sierrafoxtrot/PDP-8_Serial_AIO/discrete/simulation/tx/Simluation_151026_1.png

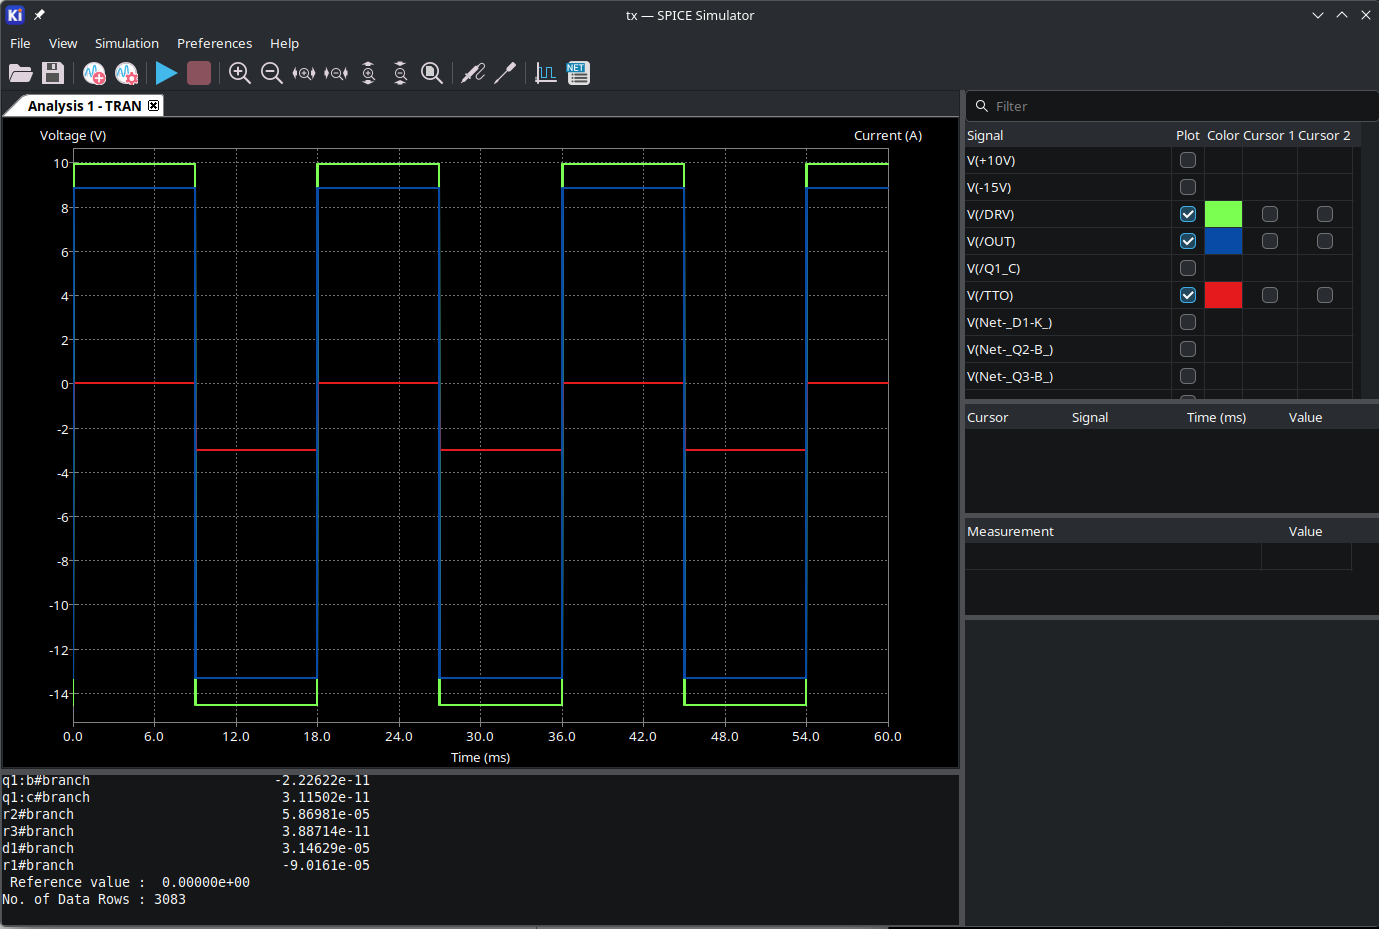
discrete/simulation/tx/Simluation_151026_1.png
