sierrafoxtrot/PDP-8_Serial_AIO/ic/PDP-8-Serial-IC.kicad_pcb

## KiCad design ic/PDP-8-Serial-IC.kicad_pcb (2026-11-01)

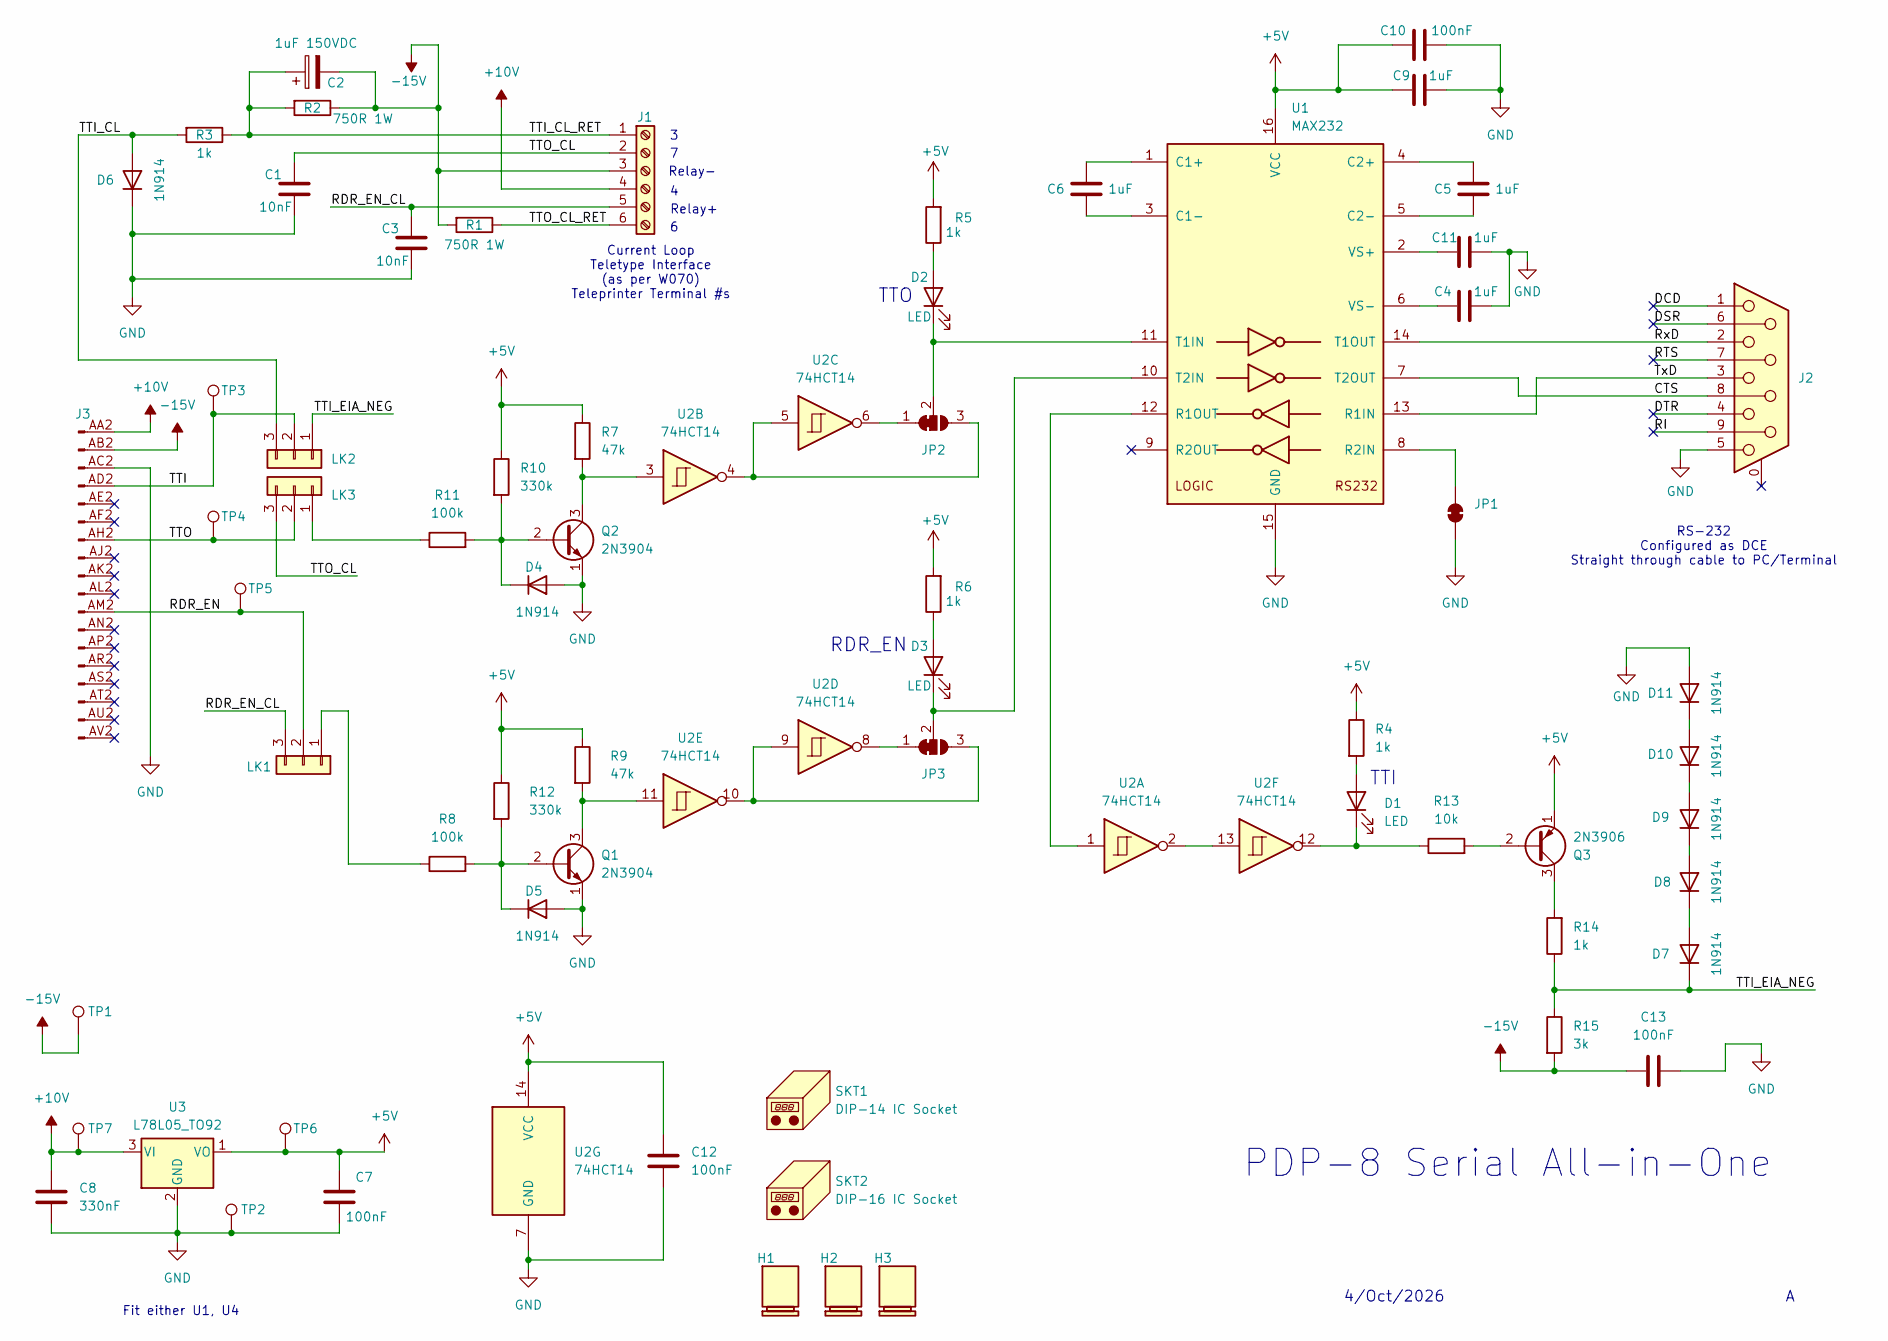
[picture p2: schematic PDP-8-Serial-IC.kicad_sch]

Parts:
C1, C3: 10nF; C_Disc_D5.0mm_W2.5mm_P2.50mm; MPN RDER71H103K0K1H03B; Digikey_PN 490-8812-ND
C2: 1uF 150VDC; CP_Axial_L29.0mm_D13.0mm_P35.00mm_Horizontal; MPN MKP1839510254; Digikey_PN 2870-MKP1839510254-ND
C4, C5, C6, C9, C11: 1uF; C_Disc_D5.0mm_W2.5mm_P5.00mm; MPN RDER71H105K2K1H03B; Digikey_PN 490-8816-ND
C7, C10, C12, C13: 100nF; C_Disc_D5.0mm_W2.5mm_P2.50mm; MPN RDER71H104K0S1H03A; Digikey_PN 490-9145-1-ND
C8: 330nF; C_Disc_D5.0mm_W2.5mm_P5.00mm; MPN FA14X7R1H334KNU06; Digikey_PN 445-180408-1-ND
D1, D2, D3: LED; LED_D3.0mm; MPN LTL1CHKEKNN; Digikey_PN 160-1943-ND
D4, D5, D6, D7, D8, D9, D10, D11: 1N914; D_DO-35_SOD27_P7.62mm_Horizontal; MPN 1N914B; Digikey_PN 1N914B-ND
H1, H2, H3: Jumper_Shunt; MPN QPC02SXGN-RC; DigiKey_PN S9337-ND
J1: Screw_Terminal_01x06; PhoenixContact_MC_1,5_6-G-3.5_1x06_P3.50mm_Horizontal
J2: DE9_Socket_MountingHoles; DSUB-9_Pins_Horizontal_P2.77x2.84mm_EdgePinOffset7.70mm_Hou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; MPN A-DF 09 A/KG-T2S; Digikey_PN AE10921-ND
J3: FlipChip_01x18; DEC_single_short_holeless
JP1: SolderJumper_2_Bridged; SolderJumper-2_P1.3mm_Bridged2Bar_RoundedPad1.0x1.5mm
JP2, JP3: SolderJumper_3_Bridged12; SolderJumper-3_P1.3mm_Bridged2Bar12_RoundedPad1.0x1.5mm_Num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
LK1, LK2, LK3: Conn_01x03; PinHeader_1x03_P2.54mm_Vertical; MPN PREC003SAAAN-RC; Digikey_PN S1012EC-03-ND
Q1, Q2: 2N3904; TO-92_Inline; MPN 2N3904BU; Digikey_PN 2N3904FS-ND
Q3: 2N3906; TO-92_Inline; MPN 2N3906BU; Digikey_PN 2N3906FS-ND
R1, R2: 750R 1W; R_Axial_DIN0414_L11.9mm_D4.5mm_P20.32mm_Horizontal; MPN RSF100JB-73-750R; Digikey_PN 13-RSF100JB-73-750R-ND
R3, R4, R5, R6, R14: 1k; R_Axial_DIN0207_L6.3mm_D2.5mm_P10.16mm_Horizontal; MPN MFR-25FBF52-1K; Digikey_PN 1.00KXBK-ND
R7, R9: 47k; R_Axial_DIN0207_L6.3mm_D2.5mm_P10.16mm_Horizontal; MPN RES 47K OHM 1% 1/4W AXIAL; Digikey_PN MFR-25FBF52-47K-ND
R8, R11: 100k; R_Axial_DIN0207_L6.3mm_D2.5mm_P10.16mm_Horizontal; MPN MFR-25FBF52-100K; Digikey_PN 100KXBK-ND
R10, R12: 330k; R_Axial_DIN0207_L6.3mm_D2.5mm_P10.16mm_Horizontal; MPN MFR-25FBF52-330K; Digikey_PN MFR-25FBF52-330K-ND
R13: 10k; R_Axial_DIN0207_L6.3mm_D2.5mm_P10.16mm_Horizontal; MPN MFR-25FBF52-10K; Digikey_PN 10.0KXBK-ND
R15: 3k; R_Axial_DIN0207_L6.3mm_D2.5mm_P10.16mm_Horizontal; MPN MFR-25FBF52-3K; Digikey_PN 13-MFR-25FBF52-3K-ND
SKT1: DIP-14 IC Socket; MPN A 14-LC-TT; Digikey_PN AE9989-ND
SKT2: DIP-16 IC Socket; MPN A 16-LC-TT; Digikey_PN AE9992-ND
TP1: -15V; TestPoint_Loop_D3.50mm_Drill0.9mm_Beaded
TP2: GND; TestPoint_Loop_D3.50mm_Drill0.9mm_Beaded
TP3: TTI; TestPoint_Loop_D3.50mm_Drill0.9mm_Beaded
TP4: TTO; TestPoint_Loop_D3.50mm_Drill0.9mm_Beaded
TP5: RDR_EN; TestPoint_Loop_D3.50mm_Drill0.9mm_Beaded
TP6: +5V; TestPoint_Loop_D3.50mm_Drill0.9mm_Beaded
TP7: +10V; TestPoint_Loop_D3.50mm_Drill0.9mm_Beaded
U1: MAX232; DIP-16_W7.62mm; MPN MAX232EIN; Digikey_PN 296-27963-5-ND
U2: 74HCT14; DIP-14_W7.62mm; MPN SN74HCT14N; Digikey_PN 296-8394-5-ND
U3: L78L05_TO92; TO-92_Inline; MPN L78L05ACZ; Digikey_PN 497-2952-ND

Connections:
+5V: C7.1, C9.1, C10.1, C12.1, Q3.1 (E), R4.1, R5.2, R6.2, R7.1, R9.1, R10.1, R12.1, TP6.1, U1.16 (VCC), U2.14 (VCC), U3.1 (VO)
+10V: C8.1, J1.4, J3.AA2 (Pin_A), TP7.1, U3.3 (VI)
-15V: C2.2, C13.1, J1.3, J3.AB2 (Pin_B), R1.2, R2.1, R15.2, TP1.1
/CTS: J2.8, U1.7 (T2OUT)
/DCD: J2.1
/DSR: J2.6
/DTR: J2.4
/RDR_EN: J3.AM2 (Pin_M), LK1.2, TP5.1
/RDR_EN_CL: C3.1, J1.5, LK1.3
/RI: J2.9
/RTS: J2.7
/RxD: J2.2, U1.14 (T1OUT)
/TTI: J3.AD2 (Pin_D), LK2.2, TP3.1
/TTI_CL: D6.2 (A), LK2.3, R3.2
/TTI_CL_RET: C2.1, J1.1, R2.2, R3.1
/TTI_EIA_NEG: D7.1 (K), LK2.1, R14.1, R15.1
/TTO: J3.AH2 (Pin_H), LK3.2, TP4.1
/TTO_CL: C1.1, J1.2, LK3.3
/TTO_CL_RET: J1.6, R1.1
/TxD: J2.3, U1.13 (R1IN)
GND: C1.2, C3.2, C4.2, C7.2, C8.2, C9.2, C10.2, C11.2, C12.2, C13.2, D4.2 (A), D5.2 (A), D6.1 (K), D11.2 (A), J2.5, J3.AC2 (Pin_C), JP1.2 (B), Q1.1 (E), Q2.1 (E), TP2.1, U1.15 (GND), U2.7 (GND), U3.2 (GND)
unnamed: D1.2 (A), R4.2
unnamed: D1.1 (K), R13.1, U2.12
unnamed: D2.2 (A), R5.1
unnamed: D2.1 (K), JP2.2 (C), U1.11 (T1IN)
unnamed: D3.2 (A), R6.1
unnamed: D3.1 (K), JP3.2 (C), U1.10 (T2IN)
unnamed: D4.1 (K), Q2.2 (B), R10.2, R11.2
unnamed: D5.1 (K), Q1.2 (B), R8.2, R12.2
unnamed: D7.2 (A), D8.1 (K)
unnamed: D8.2 (A), D9.1 (K)
unnamed: D10.2 (A), D11.1 (K)
unnamed: D9.2 (A), D10.1 (K)
unnamed: JP1.1 (A), U1.8 (R2IN)
unnamed: JP2.1 (A), U2.6
unnamed: JP2.3 (B), U2.4, U2.5
unnamed: JP3.1 (A), U2.8
unnamed: JP3.3 (B), U2.9, U2.10
unnamed: LK1.1, R8.1
unnamed: LK3.1, R11.1
unnamed: Q1.3 (C), R9.2, U2.11
unnamed: Q2.3 (C), R7.2, U2.3
unnamed: Q3.2 (B), R13.2
unnamed: Q3.3 (C), R14.2
unnamed: C6.2, U1.1 (C1+)
unnamed: C6.1, U1.3 (C1-)
unnamed: C5.2, U1.4 (C2+)
unnamed: C5.1, U1.5 (C2-)
unnamed: U1.12 (R1OUT), U2.1
unnamed: C11.1, U1.2 (VS+)
unnamed: C4.1, U1.6 (VS-)
unnamed: U2.2, U2.13

Notes on the sheet:
Relay-
TTI
Relay+
Fit either U1, U4
PDP-8 Serial All-in-One
RS-232 Configured as DCE Straight through cable to PC/Terminal
4/Oct/2026
Current Loop Teletype Interface (as per W070) Teleprinter Terminal #s
RDR_EN
TTO

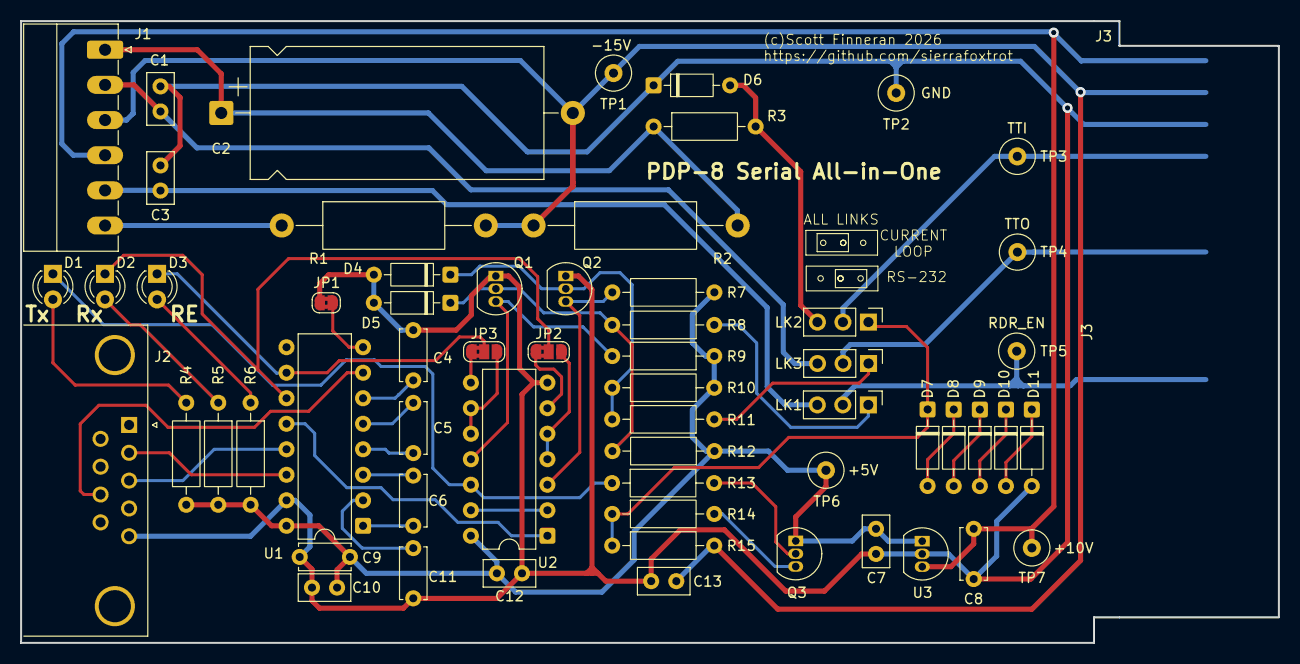
[picture p3: board PDP-8-Serial-IC.kicad_pcb from above]

Board: 2 copper layers, 125.2 x 61.9 mm, 61 parts (0 on the bottom side), 47 nets.
