sierrafoxtrot/PDP-8_Serial_AIO/discrete/hardware/PDP-8-Serial-Discrete.kicad_pcb

## KiCad design discrete/hardware/PDP-8-Serial-Discrete.kicad_pcb (2026-11-01)

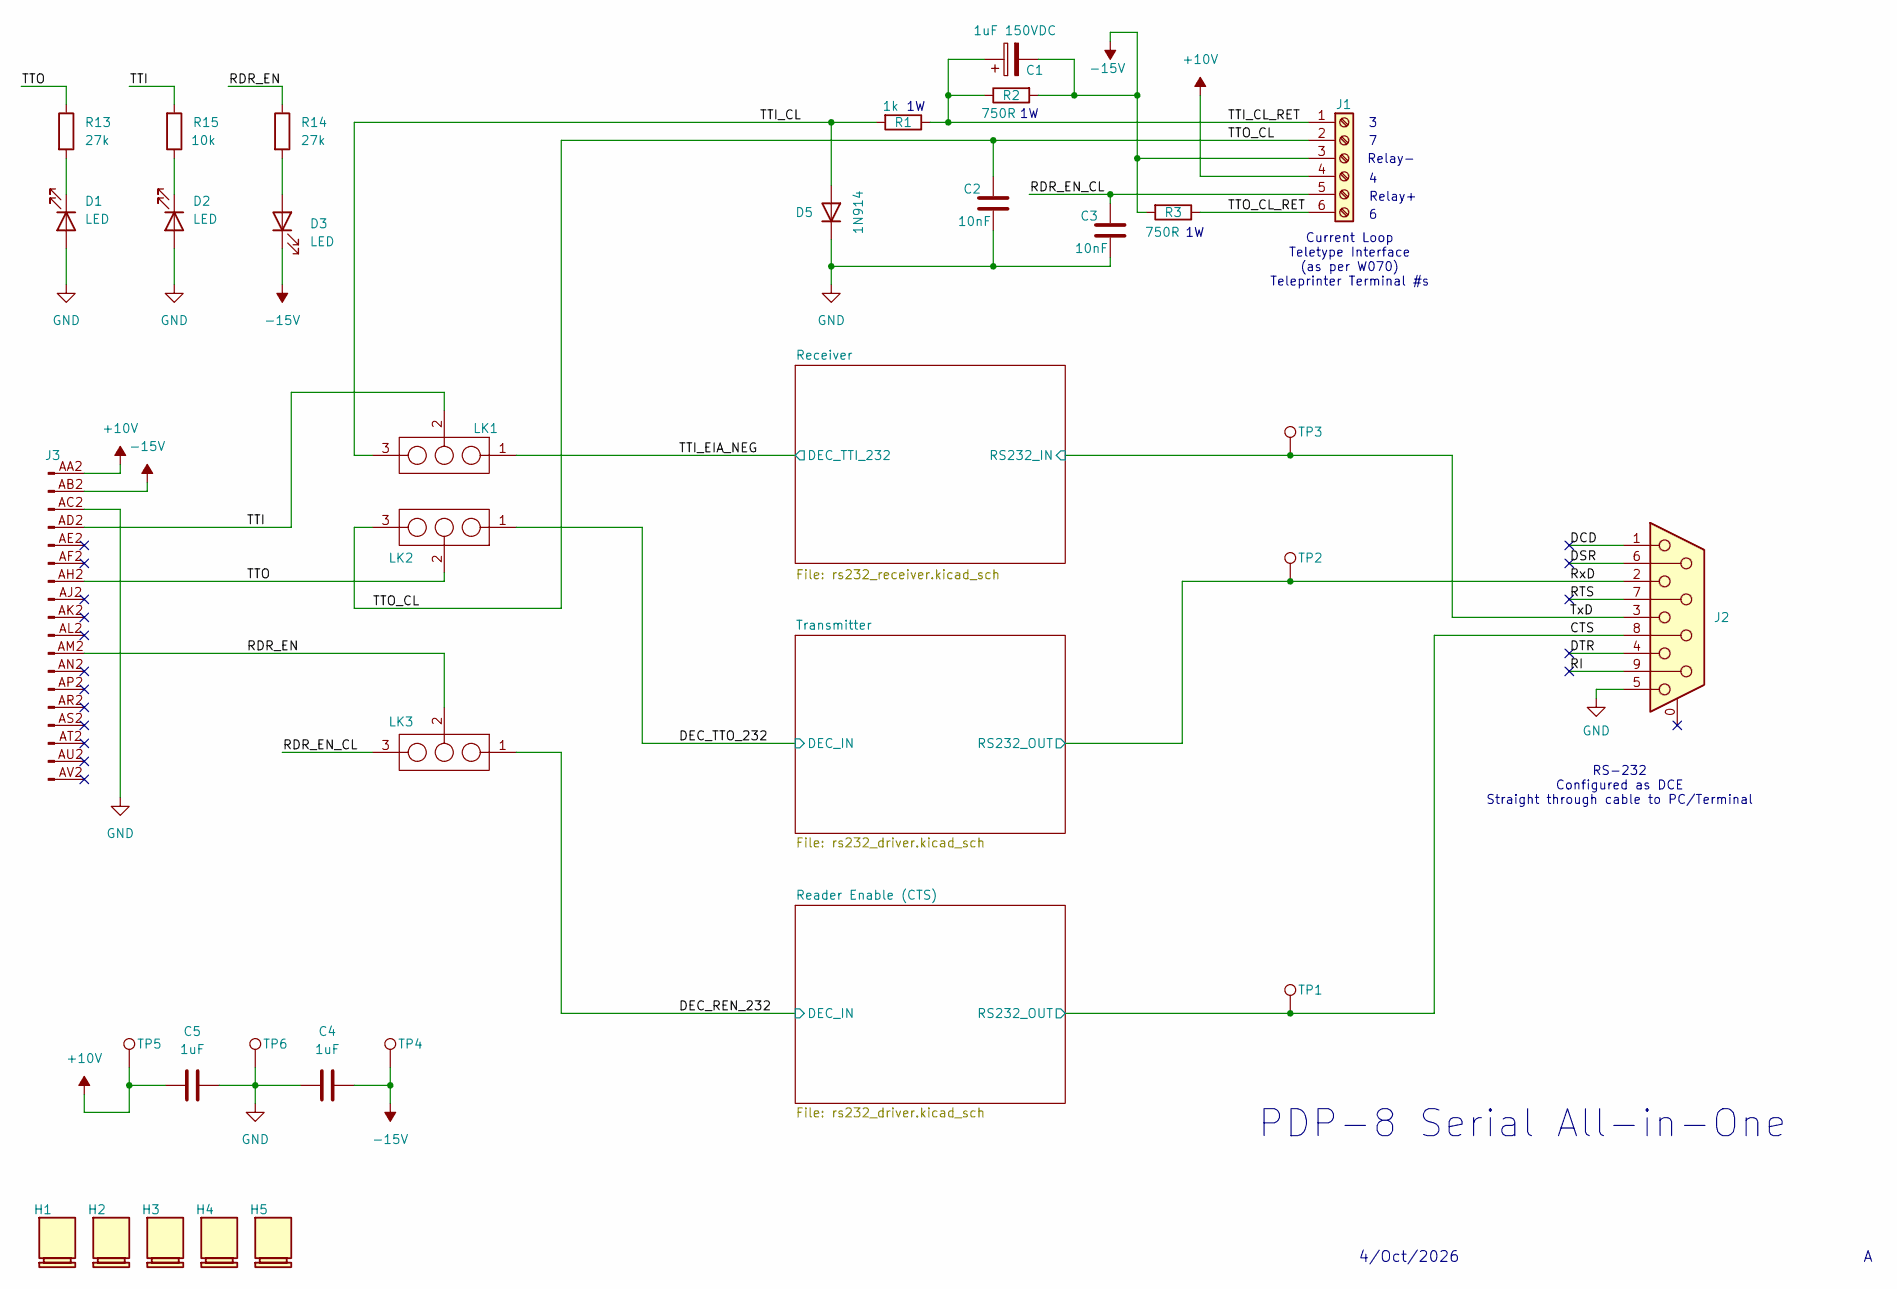
[picture p4: schematic PDP-8-Serial-Discrete.kicad_sch]

Parts:
C1: 1uF 150VDC; CP_Axial_L29.0mm_D13.0mm_P35.00mm_Horizontal; MPN MKP1839510254; DigiKey_PN 2870-MKP1839510254-ND
C2, C3: 10nF; C_Disc_D5.0mm_W2.5mm_P2.50mm; MPN RDER71H103K0K1H03B; DigiKey_PN 490-8812-ND
C4, C5: 1uF; C_Disc_D5.0mm_W2.5mm_P5.00mm; MPN RDER71H105K2K1H03B; DigiKey_PN 490-8816-ND
D1, D2, D3: LED; LED_D3.0mm; MPN LTL1CHKEKNN; DigiKey_PN 160-1943-ND
D5: 1N914; D_DO-35_SOD27_P7.62mm_Horizontal; MPN 1N914B; DigiKey_PN 1N914B-ND
H1, H2, H3, H4, H5: Jumper_Shunt; MPN QPC02SXGN-RC; DigiKey_PN S9337-ND
J1: Screw_Terminal_01x06; PhoenixContact_MC_1,5_6-G-3.5_1x06_P3.50mm_Horizontal
J2: DE9_Socket_MountingHoles; DSUB-9_Pins_Horizontal_P2.77x2.84mm_EdgePinOffset7.70mm_Hou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; MPN A-DF 09 A/KG-T2S; DigiKey_PN AE10921-ND
J3: FlipChip_01x18; DEC_single_short_holeless
LK1, LK2, LK3: Link_01x03; PinHeader_1x03_P2.54mm_Vertical; MPN PREC003SAAAN-RC; DigiKey_PN S1012EC-03-ND
R1: 1k; R_Axial_DIN0414_L11.9mm_D4.5mm_P20.32mm_Horizontal; MPN MFR-25FBF52-1K; DigiKey_PN 1.00KXBK-ND
R2, R3: 750R; R_Axial_DIN0414_L11.9mm_D4.5mm_P20.32mm_Horizontal; MPN RSF100JB-73-750R; DigiKey_PN 13-RSF100JB-73-750R-ND
R13, R14: 27k; R_Axial_DIN0207_L6.3mm_D2.5mm_P7.62mm_Horizontal; MPN RES 27K OHM 1% 1/4W AXIAL; DigiKey_PN MFR-25FBF52-27K-ND
R15: 10k; R_Axial_DIN0207_L6.3mm_D2.5mm_P7.62mm_Horizontal; MPN MFR-25FBF52-10K; DigiKey_PN 10.0KXBK-ND
TP1: CTS; TestPoint_Loop_D3.50mm_Drill0.9mm_Beaded
TP2: RxD; TestPoint_Loop_D3.50mm_Drill0.9mm_Beaded
TP3: TxD; TestPoint_Loop_D3.50mm_Drill0.9mm_Beaded
TP4: -15V; TestPoint_Loop_D3.50mm_Drill0.9mm_Beaded
TP5: +10V; TestPoint_Loop_D3.50mm_Drill0.9mm_Beaded
TP6: GND; TestPoint_Loop_D3.50mm_Drill0.9mm_Beaded

Connections:
+10V: C5.1, J1.4, J3.AA2 (Pin_A), TP5.1; also elsewhere on the board
-15V: C1.2, C4.1, D3.1 (K), J1.3, J3.AB2 (Pin_B), R2.2, R3.2, TP4.1; also elsewhere on the board
/CTS: J2.8, TP1.1; also elsewhere on the board
/DCD: J2.1
/DEC_REN_232: LK3.1; also elsewhere on the board
/DEC_TTO_232: LK2.1; also elsewhere on the board
/DSR: J2.6
/DTR: J2.4
/RDR_EN: J3.AM2 (Pin_M), LK3.2, R14.1
/RDR_EN_CL: C3.1, J1.5, LK3.3
/RI: J2.9
/RTS: J2.7
/RxD: J2.2, TP2.1; also elsewhere on the board
/TTI: J3.AD2 (Pin_D), LK1.2, R15.2
/TTI_CL: D5.2 (A), LK1.3, R1.2
/TTI_CL_RET: C1.1, J1.1, R1.1, R2.1
/TTI_EIA_NEG: LK1.1; also elsewhere on the board
/TTO: J3.AH2 (Pin_H), LK2.2, R13.1
/TTO_CL: C2.1, J1.2, LK2.3
/TTO_CL_RET: J1.6, R3.1
/TxD: J2.3, TP3.1; also elsewhere on the board
GND: C2.2, C3.2, C4.2, C5.2, D1.2 (A), D2.2 (A), D5.1 (K), J2.5, J3.AC2 (Pin_C), TP6.1; also elsewhere on the board
unnamed: D1.1 (K), R13.2
unnamed: D2.1 (K), R15.1
unnamed: D3.2 (A), R14.2

Notes on the sheet:
Relay-
Relay+
PDP-8 Serial All-in-One
RS-232 Configured as DCE Straight through cable to PC/Terminal
4/Oct/2026
Current Loop Teletype Interface (as per W070) Teleprinter Terminal #s

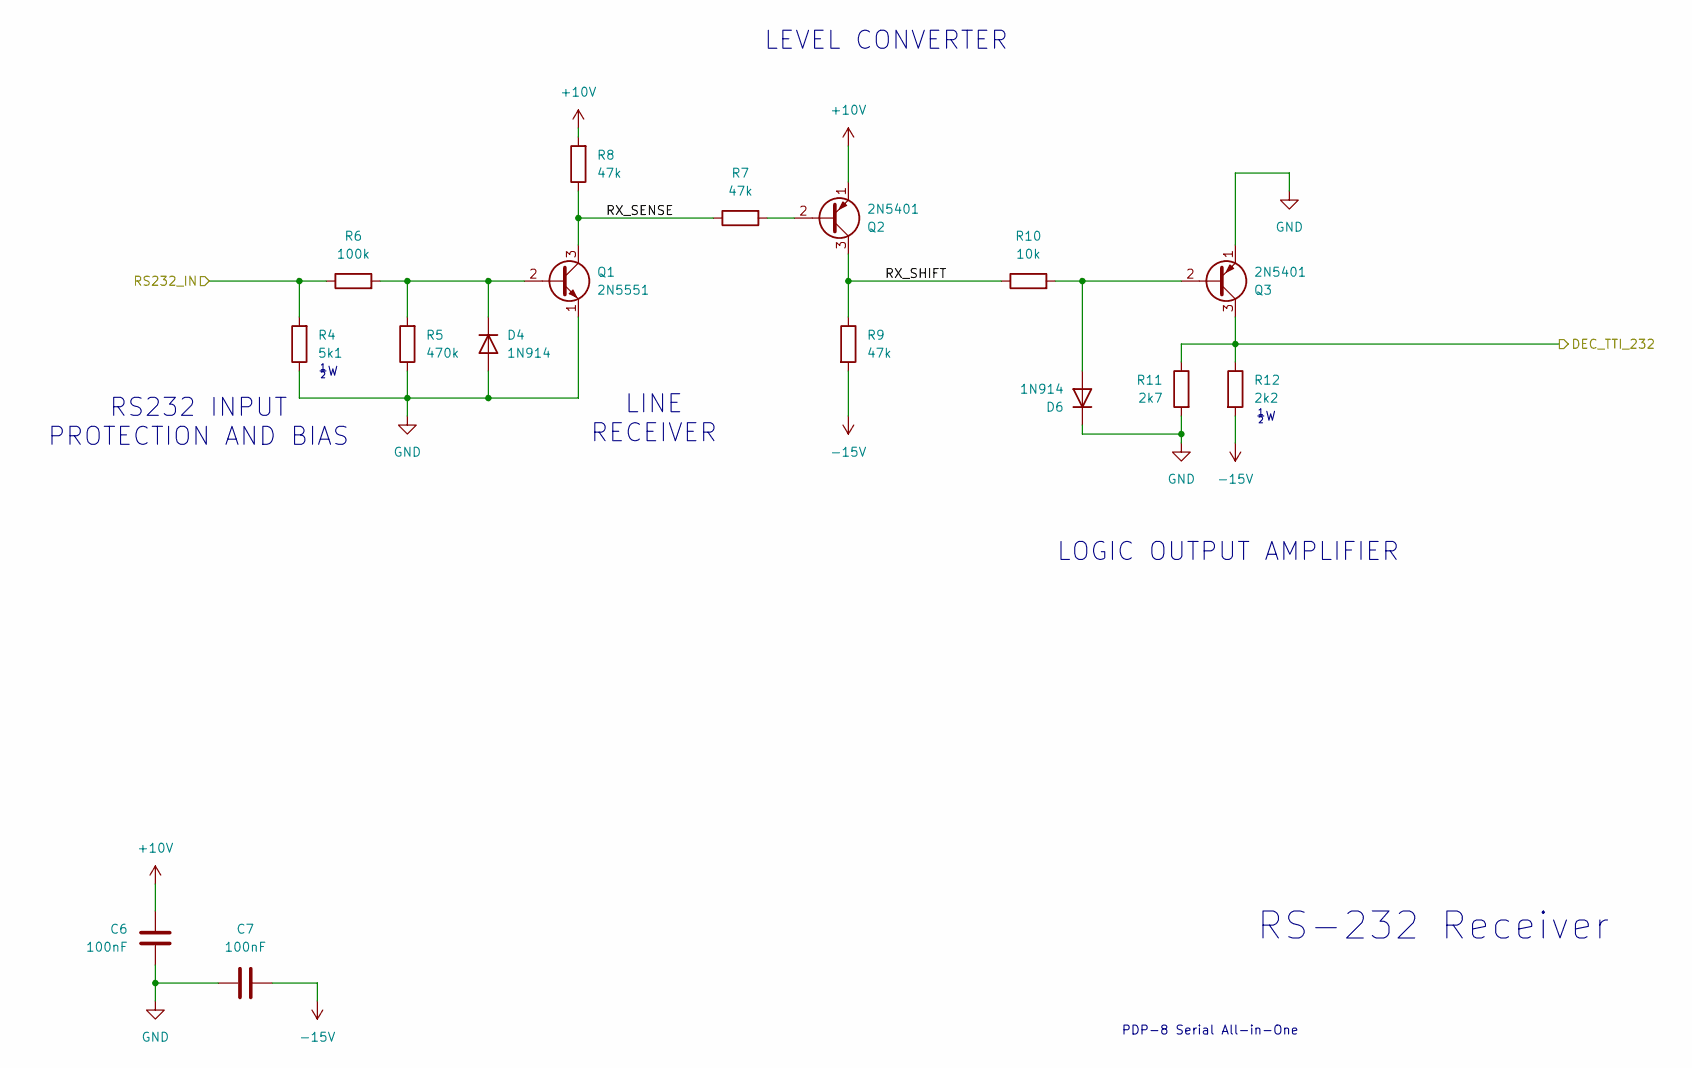
[picture p5: schematic rs232_receiver.kicad_sch]

Parts:
C6, C7: 100nF; C_Disc_D5.0mm_W2.5mm_P2.50mm; MPN RDER71H104K0S1H03A; DigiKey_PN 490-9145-1-ND
D4, D6: 1N914; D_DO-35_SOD27_P7.62mm_Horizontal; MPN 1N914B; DigiKey_PN 1N914B-ND
Q1: 2N5551; TO-92_Inline; MPN 2N5551; DigiKey_PN 4878-2N5551CT-ND
Q2, Q3: 2N5401; TO-92_Inline; MPN 2N5401; DigiKey_PN 4878-2N5401CT-ND
R4: 5k1; R_Axial_DIN0309_L9.0mm_D3.2mm_P12.70mm_Horizontal; MPN MFR-50FRF52-5K1; DigiKey_PN 13-MFR50SFTE52-5K1CT-ND
R5: 470k; R_Axial_DIN0207_L6.3mm_D2.5mm_P7.62mm_Horizontal; MPN MFR-25FBF52-470K; DigiKey_PN MFR-25FBF52-470K-ND
R6: 100k; R_Axial_DIN0207_L6.3mm_D2.5mm_P7.62mm_Horizontal; MPN MFR-25FBF52-100K; DigiKey_PN 100KXBK-ND
R7, R8, R9: 47k; R_Axial_DIN0207_L6.3mm_D2.5mm_P7.62mm_Horizontal; MPN RES 47K OHM 1% 1/4W AXIAL; DigiKey_PN MFR-25FBF52-47K-ND
R10: 10k; R_Axial_DIN0207_L6.3mm_D2.5mm_P7.62mm_Horizontal; MPN MFR-25FBF52-10K; DigiKey_PN 10.0KXBK-ND
R11: 2k7; R_Axial_DIN0207_L6.3mm_D2.5mm_P7.62mm_Horizontal; MPN RES 2.7K OHM 1% 1/4W AXIAL; DigiKey_PN MFR-25FBF52-2K7-ND
R12: 2k2; R_Axial_DIN0309_L9.0mm_D3.2mm_P12.70mm_Horizontal; MPN MFR50SFTE52-2K2; DigiKey_PN 13-MFR50SFTE52-2K2CT-ND

Connections:
+10V: C6.1, Q2.1 (E), R8.2; also elsewhere on the board
-15V: C7.2, R9.2, R12.2; also elsewhere on the board
/Receiver/RX_SENSE: Q1.3 (C), R7.1, R8.1
/Receiver/RX_SHIFT: Q2.3 (C), R9.1, R10.1
/TTI_EIA_NEG: Q3.3 (C), R11.1, R12.1; also elsewhere on the board
/TxD: R4.2, R6.1; also elsewhere on the board
GND: C6.2, C7.1, D4.2 (A), D6.1 (K), Q1.1 (E), Q3.1 (E), R4.1, R5.1, R11.2; also elsewhere on the board
unnamed: D4.1 (K), Q1.2 (B), R5.2, R6.2
unnamed: D6.2 (A), Q3.2 (B), R10.2
unnamed: Q2.2 (B), R7.2

Notes on the sheet:
LEVEL CONVERTER
RS-232 Receiver
PDP-8 Serial All-in-One
RS232 INPUT PROTECTION AND BIAS
LOGIC OUTPUT AMPLIFIER
LINE RECEIVER

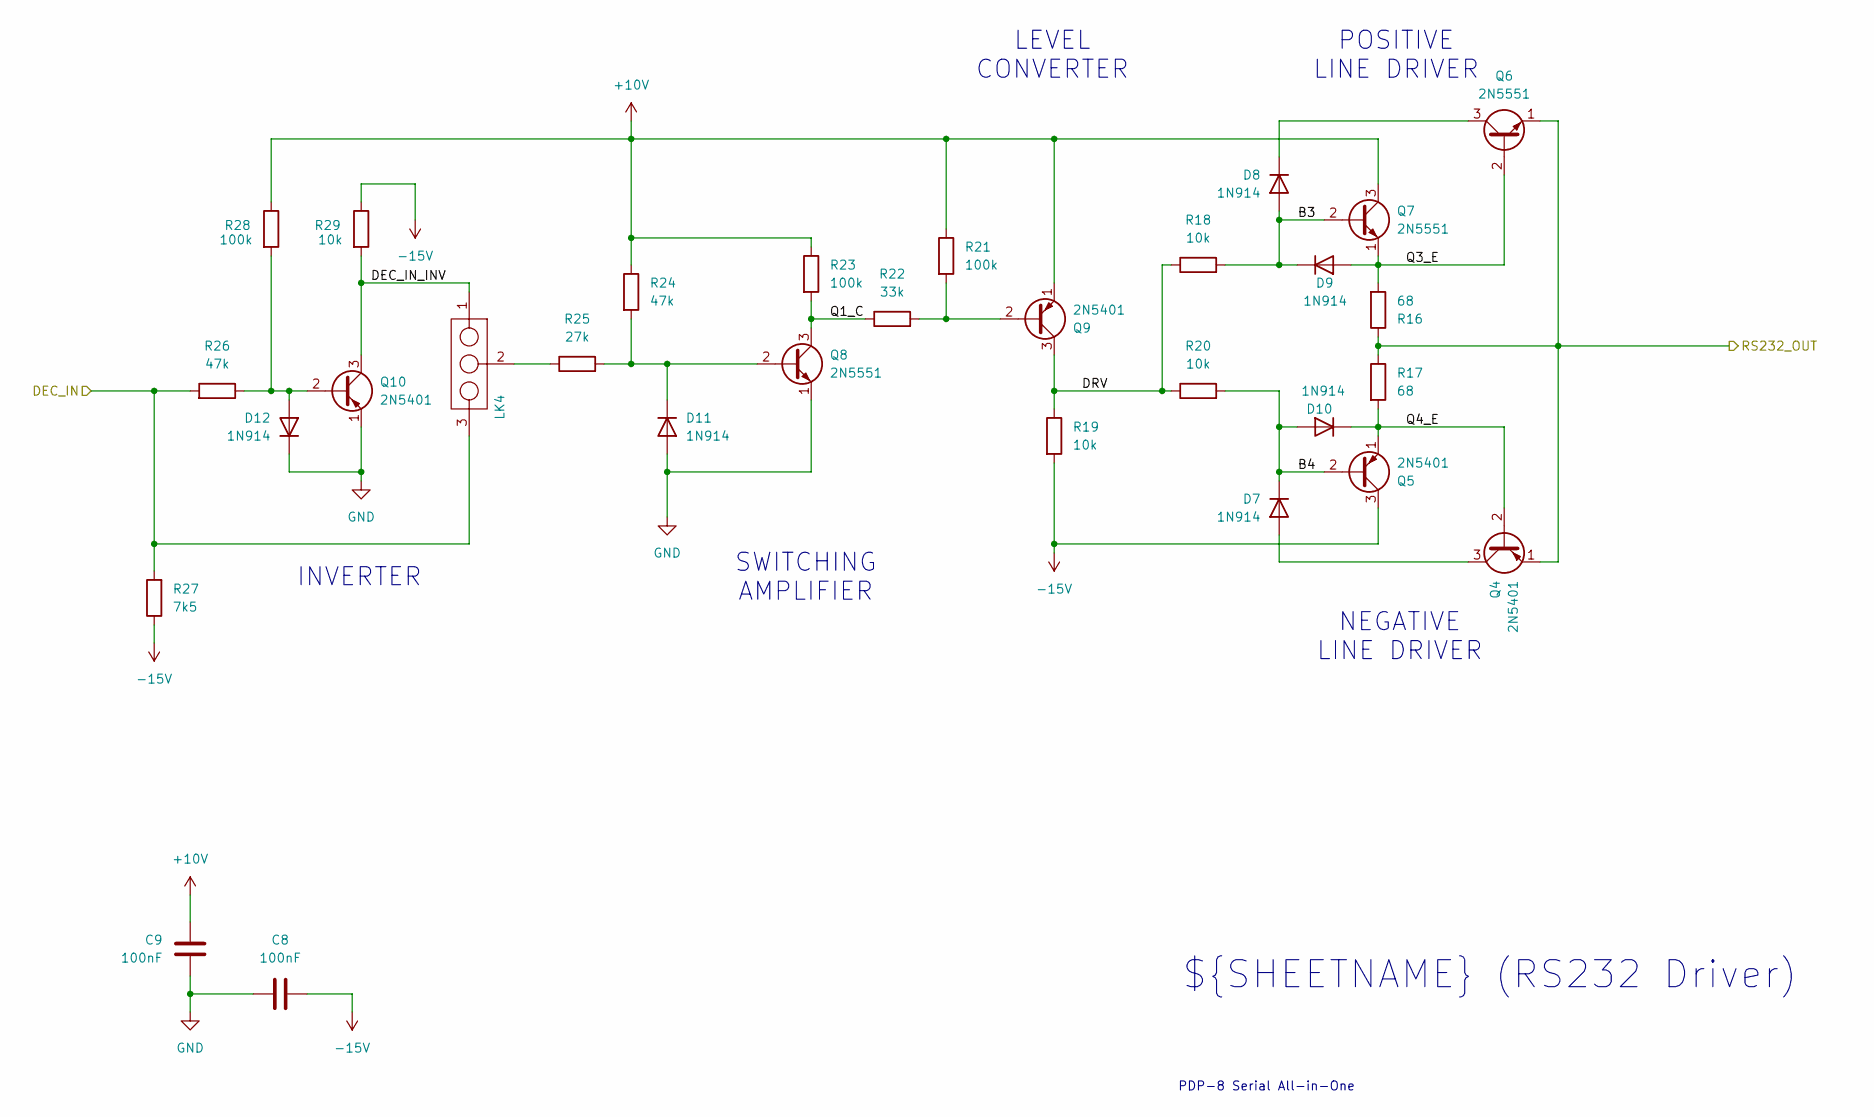
[picture p6: schematic rs232_driver.kicad_sch]

Parts:
C8, C9: 100nF; C_Disc_D5.0mm_W2.5mm_P2.50mm; MPN RDER71H104K0S1H03A; DigiKey_PN 490-9145-1-ND
D7, D8, D9, D10, D11, D12: 1N914; D_DO-35_SOD27_P7.62mm_Horizontal; MPN 1N914B; DigiKey_PN 1N914B-ND
LK4: Link_01x03; PinHeader_1x03_P2.54mm_Vertical; MPN PREC003SAAAN-RC; DigiKey_PN S1012EC-03-ND
Q4, Q5, Q9, Q10: 2N5401; TO-92_Inline; MPN 2N5401; DigiKey_PN 4878-2N5401CT-ND
Q6, Q7, Q8: 2N5551; TO-92_Inline; MPN 2N5551; DigiKey_PN 4878-2N5551CT-ND
R16, R17: 68; R_Axial_DIN0207_L6.3mm_D2.5mm_P7.62mm_Horizontal; MPN RES 68 OHM 1% 1/4W AXIAL; DigiKey_PN 13-MFR-25FBF52-68R-ND
R18, R19, R20, R29: 10k; R_Axial_DIN0207_L6.3mm_D2.5mm_P7.62mm_Horizontal; MPN MFR-25FBF52-10K; DigiKey_PN 10.0KXBK-ND
R21, R23, R28: 100k; R_Axial_DIN0207_L6.3mm_D2.5mm_P7.62mm_Horizontal; MPN MFR-25FBF52-100K; DigiKey_PN 100KXBK-ND
R22: 33k; R_Axial_DIN0207_L6.3mm_D2.5mm_P7.62mm_Horizontal; MPN MFR-25FBF52-33K; DigiKey_PN RES 68 OHM 1% 1/4W AXIAL
R24, R26: 47k; R_Axial_DIN0207_L6.3mm_D2.5mm_P7.62mm_Horizontal; MPN RES 47K OHM 1% 1/4W AXIAL; DigiKey_PN MFR-25FBF52-47K-ND
R25: 27k; R_Axial_DIN0207_L6.3mm_D2.5mm_P7.62mm_Horizontal; MPN RES 27K OHM 1% 1/4W AXIAL; DigiKey_PN MFR-25FBF52-27K-ND
R27: 7k5; R_Axial_DIN0207_L6.3mm_D2.5mm_P7.62mm_Horizontal; MPN RES 7.5K OHM 1% 1/4W AXIAL; DigiKey_PN 7.50KXBK-ND

Connections:
+10V: C9.1, Q7.3 (C), Q9.1 (E), R21.1, R23.1, R24.1, R28.1; also elsewhere on the board
-15V: C8.2, Q5.3 (C), R19.2, R27.1, R29.1; also elsewhere on the board
/DEC_TTO_232: LK4.3, R26.2, R27.2; also elsewhere on the board
/RxD: Q4.1 (E), Q6.1 (E), R16.1, R17.1; also elsewhere on the board
/Transmitter/B3: D8.2 (A), D9.1 (K), Q7.2 (B), R18.2
/Transmitter/B4: D7.1 (K), D10.2 (A), Q5.2 (B), R20.2
/Transmitter/DEC_IN_INV: LK4.1, Q10.3 (C), R29.2
/Transmitter/DRV: Q9.3 (C), R18.1, R19.1, R20.1
/Transmitter/Q1_C: Q8.3 (C), R22.1, R23.2
/Transmitter/Q3_E: D9.2 (A), Q6.2 (B), Q7.1 (E), R16.2
/Transmitter/Q4_E: D10.1 (K), Q4.2 (B), Q5.1 (E), R17.2
GND: C8.1, C9.2, D11.2 (A), D12.1 (K), Q8.1 (E), Q10.1 (E); also elsewhere on the board
unnamed: D7.2 (A), Q4.3 (C)
unnamed: D8.1 (K), Q6.3 (C)
unnamed: D11.1 (K), Q8.2 (B), R24.2, R25.2
unnamed: D12.2 (A), Q10.2 (B), R26.1, R28.2
unnamed: LK4.2, R25.1
unnamed: Q9.2 (B), R21.2, R22.2

Parts of its further copies:
C10, C11: 100nF; C_Disc_D5.0mm_W2.5mm_P2.50mm; MPN RDER71H104K0S1H03A; DigiKey_PN 490-9145-1-ND
D13, D14, D15, D16, D17, D18: 1N914; D_DO-35_SOD27_P7.62mm_Horizontal; MPN 1N914B; DigiKey_PN 1N914B-ND
LK5: Link_01x03; PinHeader_1x03_P2.54mm_Vertical; MPN PREC003SAAAN-RC; DigiKey_PN S1012EC-03-ND
Q11, Q12, Q16, Q17: 2N5401; TO-92_Inline; MPN 2N5401; DigiKey_PN 4878-2N5401CT-ND
Q13, Q14, Q15: 2N5551; TO-92_Inline; MPN 2N5551; DigiKey_PN 4878-2N5551CT-ND
R30, R31: 68; R_Axial_DIN0207_L6.3mm_D2.5mm_P7.62mm_Horizontal; MPN RES 68 OHM 1% 1/4W AXIAL; DigiKey_PN 13-MFR-25FBF52-68R-ND
R32, R33, R34, R42: 10k; R_Axial_DIN0207_L6.3mm_D2.5mm_P7.62mm_Horizontal; MPN MFR-25FBF52-10K; DigiKey_PN 10.0KXBK-ND
R35: 33k; R_Axial_DIN0207_L6.3mm_D2.5mm_P7.62mm_Horizontal; MPN MFR-25FBF52-33K; DigiKey_PN RES 68 OHM 1% 1/4W AXIAL
R36, R37, R43: 100k; R_Axial_DIN0207_L6.3mm_D2.5mm_P7.62mm_Horizontal; MPN MFR-25FBF52-100K; DigiKey_PN 100KXBK-ND
R38, R41: 47k; R_Axial_DIN0207_L6.3mm_D2.5mm_P7.62mm_Horizontal; MPN RES 47K OHM 1% 1/4W AXIAL; DigiKey_PN MFR-25FBF52-47K-ND
R39: 27k; R_Axial_DIN0207_L6.3mm_D2.5mm_P7.62mm_Horizontal; MPN RES 27K OHM 1% 1/4W AXIAL; DigiKey_PN MFR-25FBF52-27K-ND
R40: 7k5; R_Axial_DIN0207_L6.3mm_D2.5mm_P7.62mm_Horizontal; MPN RES 7.5K OHM 1% 1/4W AXIAL; DigiKey_PN 7.50KXBK-ND

Connections of its further copies:
+10V: C11.1, Q14.3 (C), Q16.1 (E), R36.1, R37.1, R38.1, R43.1; also elsewhere on the board
-15V: C10.2, Q12.3 (C), R33.2, R40.1, R42.1; also elsewhere on the board
/CTS: Q11.1 (E), Q13.1 (E), R30.1, R31.1; also elsewhere on the board
/DEC_REN_232: LK5.3, R40.2, R41.2; also elsewhere on the board
/Reader Enable (CTS)/B3: D14.1 (K), D15.2 (A), Q14.2 (B), R32.2
/Reader Enable (CTS)/B4: D13.1 (K), D16.2 (A), Q12.2 (B), R34.2
/Reader Enable (CTS)/DEC_IN_INV: LK5.1, Q17.3 (C), R42.2
/Reader Enable (CTS)/DRV: Q16.3 (C), R32.1, R33.1, R34.1
/Reader Enable (CTS)/Q1_C: Q15.3 (C), R35.1, R37.2
/Reader Enable (CTS)/Q3_E: D14.2 (A), Q13.2 (B), Q14.1 (E), R31.2
/Reader Enable (CTS)/Q4_E: D16.1 (K), Q11.2 (B), Q12.1 (E), R30.2
GND: C10.1, C11.2, D17.2 (A), D18.1 (K), Q15.1 (E), Q17.1 (E); also elsewhere on the board
unnamed: D13.2 (A), Q11.3 (C)
unnamed: D15.1 (K), Q13.3 (C)
unnamed: D17.1 (K), Q15.2 (B), R38.2, R39.2
unnamed: D18.2 (A), Q17.2 (B), R41.1, R43.2
unnamed: LK5.2, R39.1
unnamed: Q16.2 (B), R35.2, R36.2

Notes on the sheet:
${SHEETNAME} (RS232 Driver)
NEGATIVE LINE DRIVER
LEVEL CONVERTER
POSITIVE LINE DRIVER
SWITCHING AMPLIFIER
INVERTER
PDP-8 Serial All-in-One

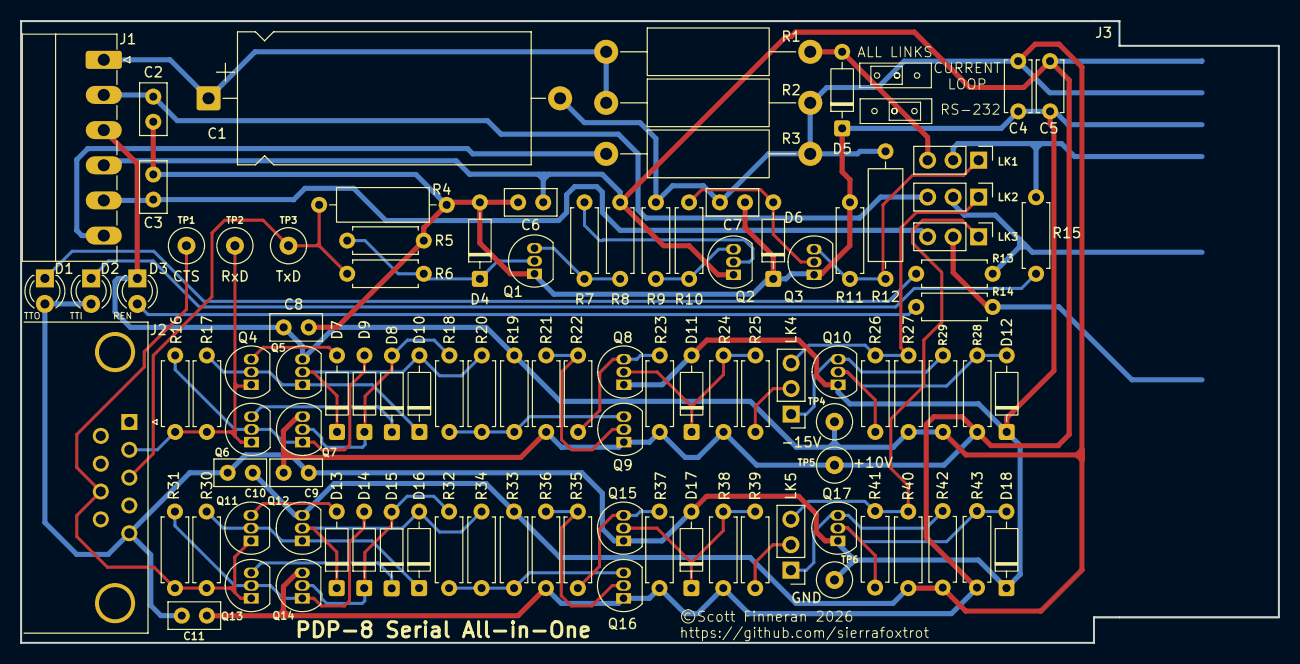
[picture p7: board PDP-8-Serial-Discrete.kicad_pcb from above]

Board: 2 copper layers, 125.2 x 61.9 mm, 103 parts (0 on the bottom side), 51 nets.
