sierrafoxtrot/PDP-8_Serial_AIO/discrete/simulation/rx/rx.kicad_sch

## KiCad design discrete/simulation/rx/rx.kicad_sch (2026-10-31)

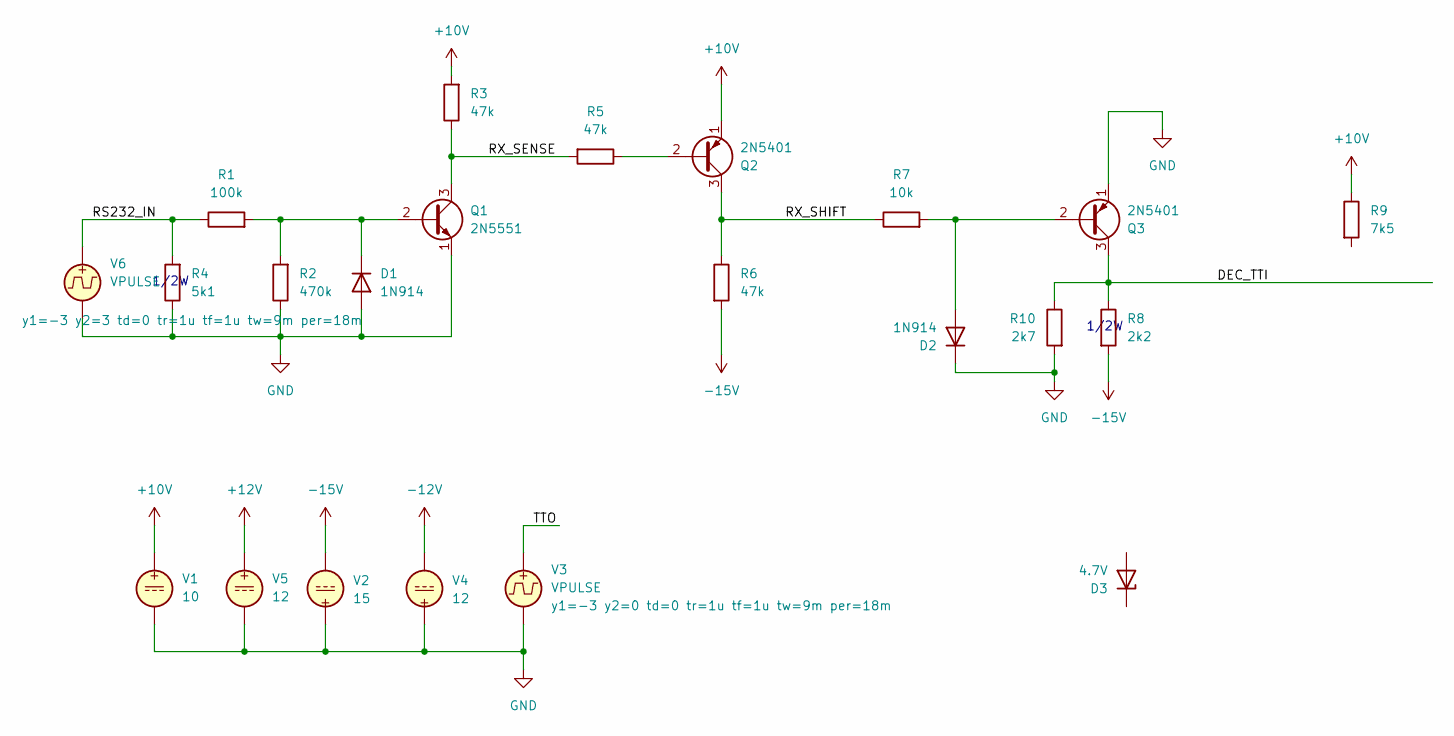
[picture p8: schematic rx.kicad_sch]

Parts:
D1, D2: 1N914; D_DO-35_SOD27_P7.62mm_Horizontal
D3: 4.7V
Q1: 2N5551; TO-92_Inline
Q2, Q3: 2N5401; TO-92_Inline
R1: 100k
R2: 470k
R3, R5, R6: 47k
R4: 5k1
R7: 10k
R8: 2k2
R9: 7k5
R10: 2k7
V1: 10
V2: 15
V3, V6: VPULSE
V4, V5: 12

Connections:
+10V: Q2.1 (E), R3.2, R9.1, V1.1
+12V: V5.1
-12V: V4.2
-15V: R6.2, R8.2, V2.2
DEC_TTI: Q3.3 (C), R8.1, R10.1
GND: D1.2 (A), D2.1 (K), Q1.1 (E), Q3.1 (E), R2.1, R4.1, R10.2, V1.2, V2.1, V3.2, V4.1, V5.2, V6.2
unnamed: D1.1 (K), Q1.2 (B), R1.2, R2.2
unnamed: D2.2 (A), Q3.2 (B), R7.2
unnamed: Q2.2 (B), R5.1
RS232_IN: R1.1, R4.2, V6.1
RX_SENSE: Q1.3 (C), R3.1, R5.2
RX_SHIFT: Q2.3 (C), R6.1, R7.1
TTO: V3.1

Notes on the sheet:
1/2W
