sierrafoxtrot/PDP-8_Serial_AIO/discrete/simulation/tx/tx.kicad_sch

## KiCad design discrete/simulation/tx/tx.kicad_sch (2026-10-31)

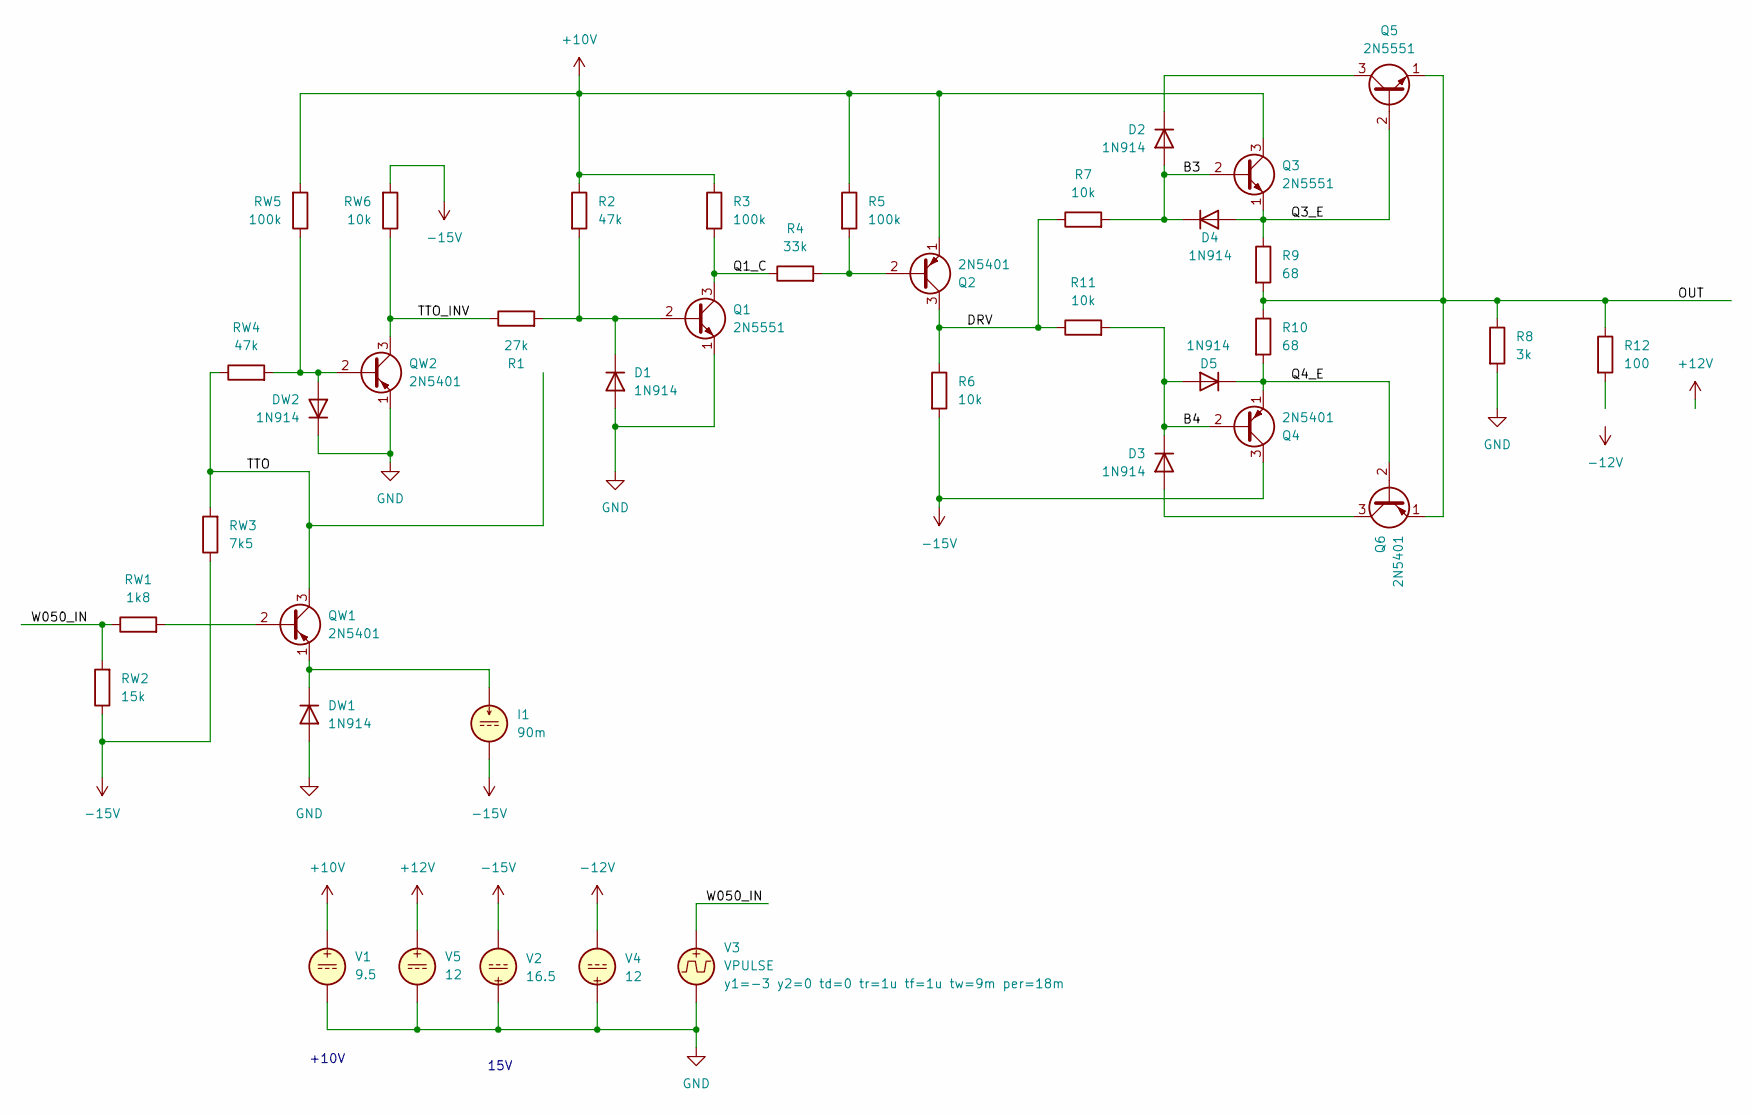
[picture p9: schematic tx.kicad_sch]

Parts:
D1, D2, D3, D4, D5: 1N914; D_DO-35_SOD27_P7.62mm_Horizontal
DW1, DW2: 1N914; D_DO-35_SOD27_P7.62mm_Horizontal
I1: 90m
Q1, Q3, Q5: 2N5551; TO-92_Inline
Q2, Q4, Q6: 2N5401; TO-92_Inline
QW1, QW2: 2N5401; TO-92_Inline
R1: 27k
R2: 47k
R3, R5: 100k
R4: 33k
R6, R7, R11: 10k
R8: 3k
R9, R10: 68
R12: 100
RW1: 1k8
RW2: 15k
RW3: 7k5
RW4: 47k
RW5: 100k
RW6: 10k
V1: 9.5
V2: 16.5
V3: VPULSE
V4, V5: 12

Connections:
+10V: Q2.1 (E), Q3.3 (C), R2.1, R3.1, R5.1, RW5.2, V1.1
+12V: V5.1
-12V: V4.2
-15V: I1.2, Q4.3 (C), R6.2, RW2.1, RW3.1, RW6.2, V2.2
B3: D2.2 (A), D4.1 (K), Q3.2 (B), R7.2
B4: D3.1 (K), D5.2 (A), Q4.2 (B), R11.2
DRV: Q2.3 (C), R6.1, R7.1, R11.1
GND: D1.2 (A), DW1.2 (A), DW2.1 (K), Q1.1 (E), QW2.1 (E), R8.2, V1.2, V2.1, V3.2, V4.1, V5.2
unnamed: D1.1 (K), Q1.2 (B), R1.2, R2.2
unnamed: D2.1 (K), Q5.3 (C)
unnamed: D3.2 (A), Q6.3 (C)
unnamed: DW1.1 (K), I1.1, QW1.1 (E)
unnamed: DW2.2 (A), QW2.2 (B), RW4.2, RW5.1
unnamed: Q2.2 (B), R4.2, R5.2
unnamed: QW1.2 (B), RW1.2
OUT: Q5.1 (E), Q6.1 (E), R8.1, R9.2, R10.1, R12.1
Q1_C: Q1.3 (C), R3.2, R4.1
Q3_E: D4.2 (A), Q3.1 (E), Q5.2 (B), R9.1
Q4_E: D5.1 (K), Q4.1 (E), Q6.2 (B), R10.2
TTO: QW1.3 (C), RW3.2, RW4.1
TTO_INV: QW2.3 (C), R1.1, RW6.1
W050_IN: RW1.1, RW2.2, V3.1

Notes on the sheet:
+10V
15V
