sierrafoxtrot/PDP-8_Serial_AIO/(commit log)

2026-10-31 Add discrete transistor serial interface for PDP 8
    Implement a W070 compatible serial interface for the original PDP 8
    (Straight 8) and standard PT08 installations, providing both traditional
    teletype current loop and RS232 connectivity.
    The design uses discrete transistor and diode circuitry for RS232
    signal conversion, avoiding dedicated line driver and receiver ICs.
    Key features:
    * Retain the original W070 current loop teletype functionality.
    * Implement discrete RS232 transmit and receive circuitry.
    * Provide signal conditioning and voltage translation between
    DEC negative logic and RS232 levels.
    * Support reader enable signalling via RS232 control lines.
    * Provide selectable operat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
2026-10-31 Added improved flip-chip footprint and shared lib for IC variant
2026-11-01 Added IC variant BOM details
