sierrafoxtrot/PDP-8_Serial_AIO/(notices)

Notices in the files:
discrete/hardware/PDP-8-Serial-Discrete.kicad_pcb:
©Scott Finneran 2026
